Connaxio/espoir-validation-hat/code/espoir_validation_microshield/README.md

# Espoir Validation microShield
This project uses the espoir-validation-mikroShield to test all available IOs on the ESP32, as well as ethernet.

Based on ESP IDF v4.4.2
