Connaxio/espoir-validation-hat/(commit log)

2022-05-09 Rename files. Add OSHW logo. DRC PASS New mikroBUS format. Removed 12V. Replaced 5.6V with 5V.
    [espoir_validation_hat.kicad_pcb, espoir_validation_mikroshield.kicad_pcb, espoir_validation_mikroshield.kicad_sch]
2022-05-12 Silkscreen fixes
    [espoir_validation_mikroshield.kicad_pcb]
2022-05-12 Move extra IOs Change board shape to mikroBUS L re-fix silkscreen
    [espoir_validation_mikroshield.kicad_pcb]
2022-05-13 Add OSHWA UID
    [espoir_validation_mikroshield.kicad_pcb]
2022-05-29 Adapt validation script for rev 0.3.6 Fix inverted SCL/SDA pins on schematics (no functional problems)
    [espoir_validation_mikroshield.kicad_pcb, espoir_validation_mikroshield.kicad_sch]
2022-05-30 Replace 7 pins header with 8 pins to facilitate soldering
    [espoir_validation_mikroshield.kicad_pcb, espoir_validation_mikroshield.kicad_sch]
