Connaxio/espoir-validation-hat/(notices)

Notices in the files:
pcb/espoir_validation_mikroshield.kicad_pcb:
Licensed under
CERN-OHL-W v2
